BlakeGarner/encoders-for-etc-eos/Hardware/SVGs/EncoderBoard_2.0mm_Black_Gloss_Acrylic.JPG

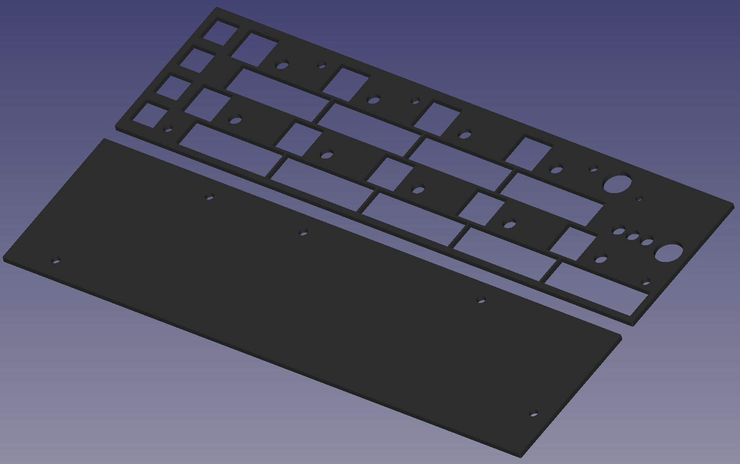
Hardware/SVGs/EncoderBoard_2.0mm_Black_Gloss_Acrylic.JPG
