BlakeGarner/encoders-for-etc-eos/Hardware/SVGs/EncoderBoard_3.0mm_Transparent_Black_Acrylic.JPG

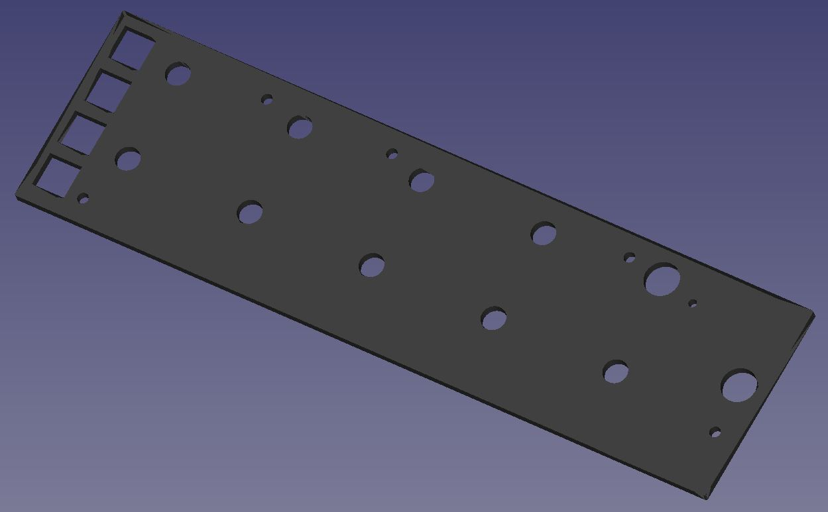
Hardware/SVGs/EncoderBoard_3.0mm_Transparent_Black_Acrylic.JPG
