BlakeGarner/encoders-for-etc-eos/Hardware/SVGs/EncoderBoard_4.5mm_Black_Gloss_Acrylic.JPG

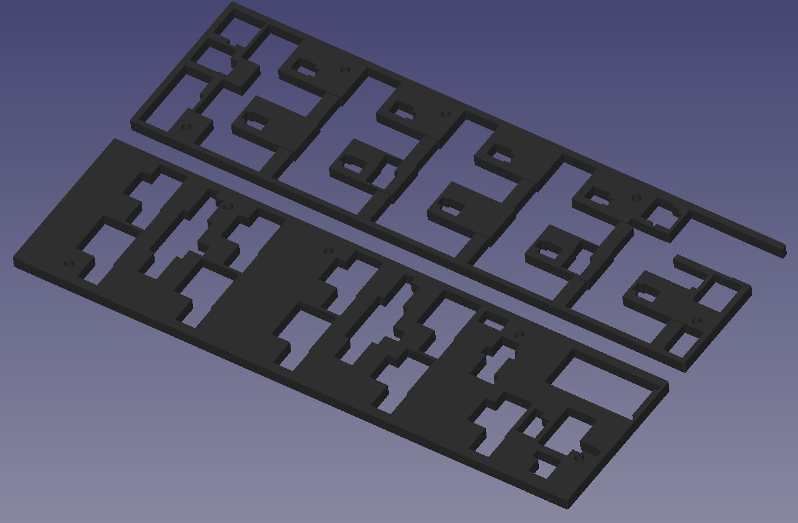
Hardware/SVGs/EncoderBoard_4.5mm_Black_Gloss_Acrylic.JPG
