BlakeGarner/encoders-for-etc-eos/(threads)

Thread 2 (2020-06-25):

R72 = capacitor ?

MalteSch2000, 2020-06-25:
Hey,
According to the parts list HTML, is R72 a   capacitor?  Is that correct?

Thank You

BlakeGarner, 2020-06-26:
It looks like the silkscreen labels for R72 + C50 are switched around.
The components highlighted when you mouse-over R72 in the BOM is correct. The silkscreen labels should be switched.
i.e. the row of six components there should be R74, R79, C51, C50, R72, R73.
The fabrication layer labels (selected by the cog) is correct for these components.

Thanks for the reporting the issue!

Thread 3 (2020-07-14):

SVG Files

MalteSch2000, 2020-07-14:
Hey, I have a problem with your SVG files.  I printed out the mid layer and it doesn't fit on board REV B. Do you have an idea?![Uploading 87447588...]()

MalteSch2000, 2020-07-14:
![Uploading 87447663...]()

MalteSch2000, 2020-07-14:
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

MalteSch2000, 2020-07-14:
Hey ,

I found the mistake.  if I import your SVG files directly into Fusion 360 the dimensions are not correct by + - 5mm.  I have now exported the file from Free CAD now it looks better.

Thank You

Closed 2020-07-14.

Thread 4 (2020-12-14):

Issue with OLED board

berto2d31, 2020-12-14:
Hi, not sure if this is the right way to ask you a question, but it looks like I screwed up when ordering the OLED boards for this project. I got this: https://www.mouser.ca/ProductDetail/Adafruit/4440?qs=xZ%2FP%252Ba9zWqYbvx21FF7rSQ%3D%3D

But when looking through everything today, the pins don't match up. It was the one part I wasn't really able to find from your BOM/parts list. Can you recommend the correct part to me on mouser or Digikey? Or does something like this have the correct pin layout? https://www.dfrobot.com/product-2019.html

Thanks in advance for your expertise, I'm definitely new at building a project like this and I appreciate any help to point me in the right direction!

BlakeGarner, 2020-12-15:
Hi, You're right - the Adafruit boards are electrically suitable, but mechanically the PCB dimensions and pin-outs do not line up with the PCB. Short of re-laying out the PCB or some unwieldy adapter board, they're not appropriate for this build.

The DFRobot boards get closer, but not close enough - they're still a little big and the pinout does not match what the PCB requires (from top to bottom: SDA, SCL, VCC, GND).

I ordered my boards from AliExpress. The quality can be variable, so you may wish to order a few spares. I hesitate to link to a particular seller as I can't vouch for their quality, but a search for "128x32 I2C SSD1306" on aliexpress should yield a number of results. You're looking for something like the attached image:
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
Key things to look out for are:
- the pin order (SDA, SCL, VCC, GND)
- dimensions of 38x12mm.
- Works at 3.3V
- I2C / SSD1306 for the comms protocol. (I2C is the bus protocol in use and SSD1306 is the messaging standard sent over the bus)

Thanks for the report - I will update the documentation at some point to make the above clearer (or PR always welcome too).

Good luck with the build!

Thread 5 (2021-05-18):

SVGs for laser cutting don’t match rev C PCB

cortices, 2021-05-18:
I laser cut the acrylic parts but they seem to suit an earlier, narrower version with the encoders directly above each other instead of staggered. Is there a newer acrylic cut file?

BlakeGarner, 2021-05-25:
Hi,
The master branch is still on the rev B PCB layout. If you want to use the newer rev C PCB layout, switch to the revC branch instead and you will find the updated acrylic SVG files.

I probably had a good reason for not merging the master branch forward, but I forget what it was!

cortices, 2021-06-01:
Whoops, thanks.

Closed 2021-06-01.

Thread 6 (2025-08-22):

Any way to purchase this?

Chewbucka, 2025-08-22:
I'm wondering if you have considered selling this as a DIY kit including all the necessary parts with some assembly or as a completed device.

BlakeGarner, 2025-08-22:
I've thought about it, but not done much more. It's something I'm happy to consider more seriously if there's interest. I think it would be useful to many, but when the build quantities are in 10-20 at a time, it's hard to hit a price point people are prepared to pay.

Chewbucka, 2025-09-01:
Just out of curiosity, what is the cost of making this project? I was looking at the JOSC encoders, but I like the way this one is done.

BlakeGarner, 2025-09-02:
A rough guess is about AU$750 for a completed version. A kitted version where you solder some of the through-hole parts and 3D print your own case might be a bit cheaper.
The teensy3.2 used as a processor is no longer available, so I'd need to switch in something newer (Teensy4.0) and update the codebase too.
