BlakeGarner/encoders-for-etc-eos/(commit log)

2019-06-01 Added initial KiCad project for board.
    [EncoderBoard.kicad_pcb, EncoderBoard.sch]
2019-06-01 Drew first revision of circuit schematic.
    This is prior to any tests / prototyping.
    [Displays&LEDs.sch, EncoderBoard.kicad_pcb, EncoderBoard.sch, Encoders&Buttons.sch]
2019-06-02 Updated all switches to LED. Added EEPROM. Added rough costing.
    Decided all switches could be LED (I can work out the colours later).
    The EEPROM is a 1Mb model - might come in handy later.
    Rough Costs was just to get a decent sense of how much this project will actually cost. Thankfully I already have some Pis...
    [EncoderBoard.sch, Encoders&Buttons.sch, Rough Parts Cost.xlsx]
2019-06-10 Updated schematic with appropriate symbols and latest library.
    [Displays&LEDs.sch, EncoderBoard.sch, Encoders&Buttons.sch]
2019-06-12 Generated draft footprint PCB with (very) approximate placements.
    [Displays&LEDs.sch, EncoderBoard.kicad_pcb, EncoderBoard.sch, Encoders&Buttons.sch]
2019-07-10 Tidied up the encoder board, updated debounce logic for schematic.
    [EncoderBoard.kicad_pcb, EncoderBoard.sch, Encoders&Buttons.sch]
2019-07-11 Completed final drafting of Encoder Board.
    Not quite submitted yet - but pretty close to the final layout for the board to be made.
    [EncoderBoard.kicad_pcb, Encoders&Buttons.sch]
2019-07-12 Further improvements to PCB layout.
    Fixed up silkscreen layout.
    [EncoderBoard.kicad_pcb]
2019-07-15 Final version of Rev A board.
    - Fixed up address pins on some chips.
    - Added some additional bypass capacitors.
    - Fixed up some broken footprint references.
    - Some minor layout adjustments.
    [Displays&LEDs.sch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]
2019-07-23 Small changes.
    [EncoderBoard.kicad_pcb, Encoders&Buttons.sch]
2019-07-26 First Draft of acrylic case stencils
    [EncoderBoard.kicad_pcb]
2019-07-26 Second Draft of acrylic case.
    [EncoderBoard.kicad_pcb, Height Stackup.xlsx]
2019-07-27 Redo of SVGs as something was weird in the last lot (scaling was out by 0.1mm).
2019-08-21 Final revision of Rev A Board + Acrylic Case
    [EncoderBoard.kicad_pcb, Encoders&Buttons.sch]
2020-06-02 v1.0.0 build of project.
    Added LICENSE, NOTICE file. Add README to firmware folder.
    Adjusted VID and PID to mimic Arduino Uno.
    Ported entire arduino project to pure cpp program in VS Code.
2020-06-02 Small fixes - including cleanup of VERSION macro.
    [hardware.h]
2020-06-02 Cleaned up a few hardware files, added more hardware todos.
    [EncoderBoard_revA.csv, EncoderBoard_revA.xlsx]
2020-06-02 Added README for EncoderBoard folder.
2020-06-02 Some changes to hyperlinks in EncoderBoard README.
2020-06-02 Renamed EncoderBoard folder to Hardware
    [Displays&LEDs.sch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]
2020-06-02 Removed out-of-date Rough Parts Cost.xlsx and Height Stackup.xlsx.
    You can find the most current BOM in the bom folder.
    [Height Stackup.xlsx, Rough Parts Cost.xlsx]
2020-06-02 Fixed missing pull-up resistors and published RevB of PCB.
    [EncoderBoard-B_Cu.gbl, EncoderBoard-B_Mask.gbs, EncoderBoard-B_Paste.gbp, EncoderBoard-B_SilkS.gbo, EncoderBoard-Edge_Cuts.gm1, EncoderBoard-F_Cu.gtl, EncoderBoard-F_Mask.gts, EncoderBoard-F_Paste.gtp]
2020-06-02 Updated sheet rev numbers
    [Displays&LEDs.sch, EncoderBoard.kicad_pcb, EncoderBoard.sch, Encoders&Buttons.sch]
2020-06-03 Updated schematic and BOM spreadsheets with Manufacturer and Part Numbers
    [Displays&LEDs.sch, EncoderBoard.sch, EncoderBoard_revB.csv, EncoderBoard_revB.xlsx, Encoders&Buttons.sch]
2020-06-16 Fixed incorrect package in SN74HCT245. Should have been TSSOP instead of SOIP.
    [EncoderBoard.sch, EncoderBoard_revB.csv, EncoderBoard_revB.xlsx]
